kevinferrare/arduino-st4/Hardware/final_back.jpg

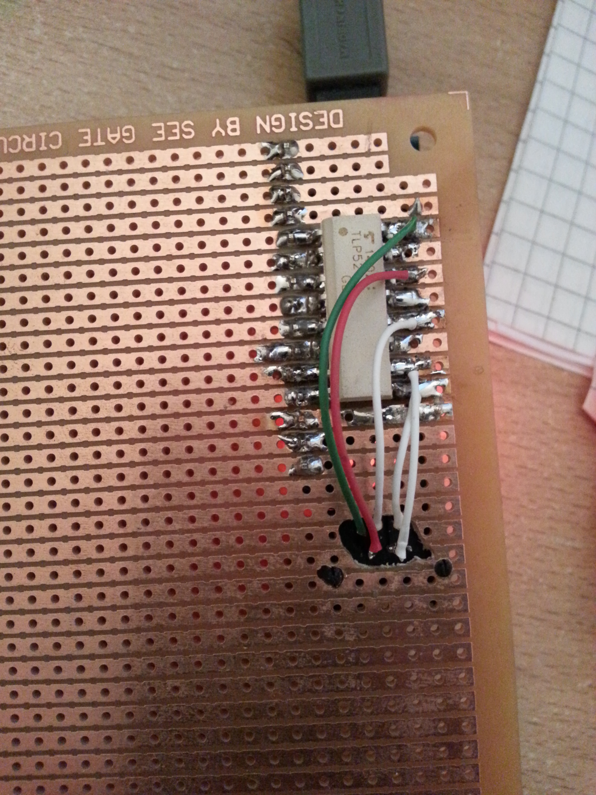
Hardware/final_back.jpg
