kevinferrare/arduino-st4/Hardware/final_case.png

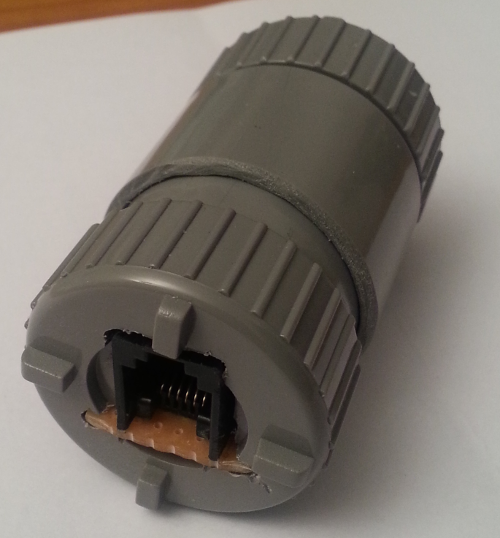
Hardware/final_case.png
