kevinferrare/arduino-st4/Hardware/final_front.jpg

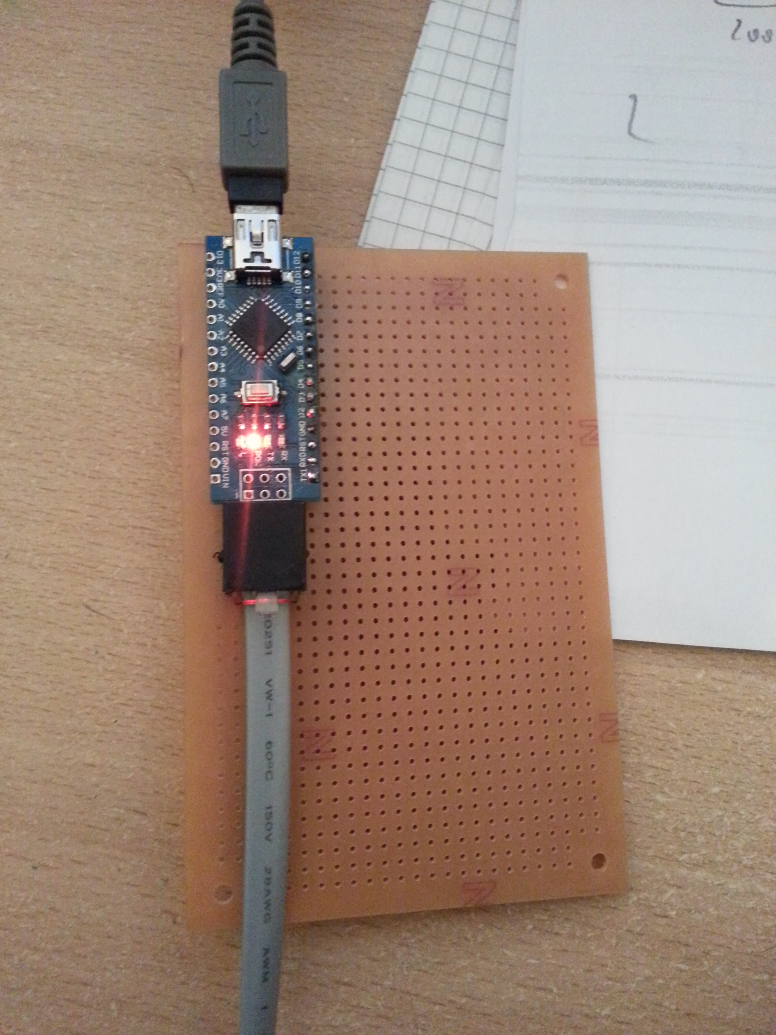
Hardware/final_front.jpg
