kevinferrare/arduino-st4/(threads)

Thread 2 (2016-02-14):

ST-4 upload issue

gary143616, 2016-02-14:
I have uploaded the software and received a"finished uploading" message, the red LED is on, the green LED stopped flashing  but the hardware does not seem to respond to commands, COMMAND+# does not turn the LED on or off, the only change is that a yellow LED gives one fast flick when the command is executed.
I also have a window with the following message:
void setup() {
  // put your setup code here, to run once:

}

void loop() {
  // put your main code here, to run repeatedly:
This is my first contact with Arduino and uploading code so I have no idea what to do next.
I would very much appreciate some assistance.
Thanks,
Gary

kevinferrare, 2016-04-11:
Hello Gary,

It seems that you are uploading an empty arduino program instead of the sketch I link in the installation steps.

If this is the first time you use an arduino, I recommend that you try to upload the examples built-in with the arduino IDE software.
There are a lot of resources on the internet on how to do so.
You could start with the arduino forums.

Closed 2016-07-25.

Thread 3 (2016-07-20):

INDI driver

tliff, 2016-07-20:
I've got a basic INDI driver working for the arduino adapter https://github.com/tliff/indi_ardust4.

Just autoguiding, no GOTO but it's a start.

kevinferrare, 2016-07-25:
Hello @tliff,

Thank you for implementing this!
I will link your code from the main page.
Implementing GOTO was a bit tricky with ASCOM since I had to use threads in order to emulate asynchronous slewing.

Regards,
Kevin

Thread 4 (2017-08-09):

Only 1 program can be connected to the Arduino trough the ASCOM driver

grozmaistor, 2017-08-09:
Only one program for instance Skycharts or PHD can be connected at a time, while the idea of ASCOM is to have the possibility to connect many via the ASCOM driver.

As I see it, the driver should be rewritten in a way that it determines the Arduino device on which port is running and the user is forbidden or hidden the selection for COM port.
Also when you connect a program(PHD) via the ascom driver to the device and disconnect it, the next time you try to connect to the device on the com port it fails, unless you restart the program(PHD).

kevinferrare, 2017-08-12:
Hello,

I am not sure I understand all your points.
Regarding the possibility to have multiple clients for a driver, I am not sure ASCOM supports it.
There is a software that acts as a hub between clients and driver here if it can help: http://www.optecinc.com/astronomy/downloads/ascom_server.htm

Regarding the issue with PHD, I did some tests, and PHD never tells the driver to disconnect, so I made a fix and included it in the next version that is to be released once I properly test it in the field ...
Here is the exe if you are interrested:
https://drive.google.com/open?id=0B04IJvbw0nqmMUJVX25MQ2NJNFU

kevinferrare, 2017-08-17:
Seems like PHD is never disconnecting the driver when clicking on disconnect:
https://github.com/OpenPHDGuiding/phd2/blob/master/scope_ascom.cpp#L416

kevinferrare, 2017-08-17:
@grozmaistor
You can use the Hub included into ASCOM that allows multiple clients to control a single device simultaneously:
http://www.ascom-standards.org/FAQs/POTH.htm

Highland-Logan, 2025-03-09:
The ASCOM Hub, will not allow full useable, as slewing appears to not function. However you can use the [Optec ASCOM Server](https://ftp.optecinc.com/downloads/legacy/optecascomserver/). I am able to slew to targets using NINA, while connected to Stellarium to centre scope and PHD2 as guiding program.

Thread 6 (2017-12-26):

Arduino st-4 driver not recognised by ASCOM

borsaci06, 2017-12-26:
Thank you for your wonderful work. I made the hardware with Arduino Nano and tried to use it on my EQ5 mount. I already have latest ASCOM platform installed and using Cartes du Ciel. I downloaded and installed your Arduino st-4 driver and tried it on CartesDuCiel. however when trying to connect to telescope, I select the ArduinoST-4 (I see it on the list of available HW) it says that the driver is incompatible and does not let me to enter Properties window. Actually it says that the DLL file is not found in CommonFiles/ASCOM/Telescope directory, but when I check the file it looks for is there.
Any help will be appreciated... I really want this to work...

DominiqueMACHU, 2018-03-10:
Hello,
I realized this project with an Arduino R3 (ch340) and no problem with "Cartes du Ciel " and Stellarium. In the presentation of my project,  I explain the configuration of these applications:

https://github.com/DominiqueMACHU/Interface-Arduino-ST4-for-NEQ5/tree/Hardware

Greetings

Dominique

Thread 7 (2018-03-09):

My version of "Arduino ST4"  for my NEQ5

DominiqueMACHU, 2018-03-09:
Hello Kevin,
A big thank you for your project, I realized this winter my version based on an ARDUINO UNO R3 (ch340) for my mount NEQ5.
I just finished the tests everything is OK.
I come to publish the realization of this project on GitHut :

https://github.com/DominiqueMACHU/Interface-Arduino-ST4-for-NEQ5

I look forward to your new version.

friendships

Dominique (Lyon-France)

kevinferrare, 2018-03-13:
Hi Dominique,

I would be interested in seing what you did, but the repository your link points to only has a readme.md file.

Did you commit your files?

Kind regards,
Kevin

DominiqueMACHU, 2018-03-13:
Hi Kevin,

The file is in the branch "hardware", i copy them in master branch.
Excuse me it's my first utilisation of GITHUB!

Kind regards,

Dominique

kevinferrare, 2018-03-13:
Oh!

I see you made a nice PDF manual explaining how to build the hardware and how to use it in various softwares.
However I see no code although I see that the configuration window is different from your screenshots.
Did you change the code?

DominiqueMACHU, 2018-03-13:
No,  I did not change the code, it's version 1 of your original code.

In my first version I had cabled the Rj12 as the standard ST4 :
"ST-4 style guide ports (sometimes referred to as home ports or CCD ports) look
like the diagram shown to the right. The pins are connected as:
Pin 1: Not usually connected
Pin 2: Common (ground)
Pin 3: RA +
Pin 4: Dec +
Pin 5: Dec-
Pin 6: RA
"
-->  and all orders were reversed!
I had modified your code by inverting the controls and the telescope go well on the targets.
Finally I rewired the case "Dual Axis" and install your original code V1.
The telescope goes well on its targets in GOTO mode, the only problem encountered in your version is the passage of the meridian where the DEC commands are reversed!
I am waiting for your official version for this modification, in your ASCOM driver? I think ?.

Thank you for your project this interface ST4 is a + to find the objects of the sky since a star of reference.

Sincerely

Thread 8 (2018-08-14):

Autoguider

hmovahedim, 2018-08-14:
hello sir.
how can use it for my autoguider ?
and how can i send amount of changes to arduino ?

kevinferrare, 2018-08-31:
Arduino only supports on / off commands for both axis.
Timing is handled in the ASCOM driver.

hmovahedim, 2018-08-31:
Thanks.
It's very useful.

Thread 11 (2020-12-16):

Question regarding pooling rate

CyberianIce, 2020-12-16:
If PHD2 sends RA+# command over ST4 interface, for how long this "button" should remain pressed? What happen if you hit RA+ button on your remote? How many steps single press of buttons make?

CyberianIce, 2020-12-24:
More important is how your ArduinoST4 ASCOM driver handle PulseGuide duration opcodes?

kevinferrare, 2021-01-26:
Hello @CyberianIce !

It remains pressed until RA0, RA- or RESET is issued, so the telescope will move until told to stop.
If you hit RA+ on the remote, it probably won't affect the move. The number of steps depends on your specific mount and the duration of the press.

PulseGuide takes in input a direction and a duration, the driver then sends a command to the arduino to start the move in that specific direction, waits for the specified duration and then stops.

Hope this answers your questions.

Thread 12 (2021-08-16):

Connection timed out

Ferwol, 2021-08-16:
Hi!
I am having a hard time making st4 work. When I try to connect I get a time out error
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
Already tried changing COM baudrate to 57600 and nothing happens.
What am I doing wrong?
Thanks!

kevinferrare, 2021-08-16:
Are you able to send commands through the arduino IDE as suggested in the readme?

Ferwol, 2021-08-16:
Yes, and I see "OK#" after sending commands

Ferwol, 2021-08-16:
Should I try an older version of Ascom platform? I am stuck with this error 😵😵

Ferwol, 2021-08-16:
I am using a ch340 Arduino Nano. On a couple of days will be trying with an original one.

Ferwol, 2021-08-18:
Well, It seems that one problem was I was using a copy if Nano and not the original. Now I can connect Cartes du ciel to st4. Phd2 is being a bit more tricky, but that is a different issue.
Thanks for the attention!

Closed 2021-08-18.

Thread 13 (2021-08-19):

Can't open properties on PHD2

Ferwol, 2021-08-19:
Hi again.
First of all, thanks for all the work behind this proyect.
I am close to connect "arduinost4" to PHD2. In Ascom diagnostics everything seems fine (screenshot 1), Cartes du Ciel connects to st4 and I can set different COM port in properties.
But, in PHD2 I click on properties button and nothing happens. Trying to connect will send an error (screenshot 2) and if I try to set properties via Device Hub the error is different (screenshot 3).
Tried unistalling and installing Ascom, phd2 and driver several times. Checked registry with CCleaner. Also installed 1.1 driver version. Don´t know what else could I do. I am stuck.
Thank you again!!

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

Closed 2021-08-23.

Thread 14 (2022-09-19):

Implementation on a standalone ATmega328 uP

nevilyoung, 2022-09-19:
Hi Kevin or anybody -
Perhaps I am trying to be too clever because I decided to use an ATmega328 chip on its own for space saving reasons. I can get the autoguider code to work if I go through the standard Arduino microcontroller board, but not through the standalone chip, with which I communicate through a FT232 USB to serial adapter. That works fine for communicating with and successfully programming the uP (eg Blink), but I cannot communicate with the autoguider that has been loaded onto the chip. I suspect that the Autoguider driver cannot see the auotoguider through the FT232 driver. I have tried various combinations of COM ports.
Am I doing something silly here? Would there be conflicts between drivers and ports?
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

SteveBz, 2022-09-19:
If it works from the pc via the usb and ft232 with blink on the 328, it'll work with anything.  It's probably something silly, like a line terminator or baud rate or something.

nevilyoung, 2022-09-20:
OK - so it should work. Baud rates double checked. The autoguider code is as written by Kevin and works fine when run on the microcontroller board. I have put the question to the Arduino forum, so if I find a solution, I will post it here. Thanks.

nevilyoung, 2022-09-21:
Another possibility - Arduino IDE can see the ATmega328 chip through the FT232. Perhaps there is something in the Arduino driver that makes that happen. Perhaps whatever the 'something' is in the Arduino driver is not in Kevin's autoguider driver. Of course he was not considering that the autoguider would be used on a standalone ATmega328 - if that makes a difference.
BTW - I registered on the Arduino forum 24 hrs ago but am 'on hold' while I am being vetted. Can't wait to post my question there.

nevilyoung, 2022-10-01:
Finally found an answer at Arduino forum. In case someone else runs into this problem, here is the long story. Jump to the end to see the solution.

NOTE: I eventually found a solution to this problem (see below), but here is the scenario:
My implementation for a telescope autoguider uses a standalone Atmega328. I communicate with it via an FT232 USB-Serial converter board. I can download Kevin's Arduino Autoguider program to the chip.  I can download Blink to the standalone 328 - it works just fine.

I am using an an autoguiding program called PHD2. PHD2 cannot communicate with the Arduino Autoguider because the computer only sees the FT232 board.

If I instead programmed the Arduino Autoguider program into an UNO board, (which means that I am now using the UNO’s onboard USB-Serial converter), the Arduino Autoguider program works just fine. The is no apparent clash between the autoguider and the FT232 drivers.

My question was: Should it be possible to communicate with the autoguider on the standalone Atmega328 via the FT232?
While I was writing up this post on the forum, I was prompted to look at this post “_Standalone ATMEGA328 with CP2102 USB-Serial Converter_”, which had not cropped up in my previous searches.

@iceeyes1992 – had the exact solution.
_“i had the same problem.i had a atmega328p and a cp2102 with dtr pin.i tried different ways.after spend of 3 days i found the solution.
after burn bootloader to raw atmega328p with arduino as isp or usbasp you must choose only arduino pro or pro mini as your board in tools menu and one of the avr isp or arduino as isp or avr isp mkll as programmer.and then upload your sketch.that’s it.”_

NOTE: I had burned a bootloader onto the Atmega328 earlier via the UNO board. And then had uploaded the Arduino Autoguider sketch, probably with _Board: Arduino UNO_ selected – I think. Uploading worked fine, but PHD2 did not see the autoguider. The COM port was 4 and called something like “_Serial Converter_” when I was expecting to see “_ArduinoST4 telescope driver (ASCOM)_”.

So – following the advice from @iceeyes – I reconnected to the standalone ATmega through the FTP232 converter. I simply selected _Board: “Arduino Pro or Pro Mini_”. An extra field opens up – _Processor_, from where I selected the “_Atmega328P (5V, 16Mhz)_”. I then uploaded the AutoguiderST4 program again.

The PHD2 guiding program then saw the “_ArduinoST4 telescope driver (ASCOM)_” in the _Mount_ selection list in PHD2.  Success! Guiding is working fine.

(Note: PHD2 will not connect to the autoguider after the Arduino IDE has been connected to the 328. Messages received were COM4 denied or other times response too slow. I had to unplug the autoguider, then plug it in again. )

Bottom line – for standalone Atmega through USB-Serial converter, **_Select Arduino pro or pro mini as your board_**.
PS: I might be mistaken about some of the sequences, but became very confused while sorting out the problem over several days. Hope this is useful.

Thank you Kevin!
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

Thread 16 (2024-07-16):

Adding LED indicators

strumf666, 2024-07-16:
Hi,

First, a big thanks for creating this interface for owners of old mounts. I built it for my eq5, the only thing I am missing are output led indicators.
Can I simply add 5V LEDs between respective optocupler outputs and RJ12 port?

strumf666, 2025-04-07:
Doesn't work as proposed above, but it does work if I wire the led between arduino output and optocoupler input.

Closed 2025-04-07.

Thread 17 (2025-03-19):

Connection timeout with EQMOD

elandrew908, 2025-03-19:
Hi,

I have built a circuit as per Kevin's diagram (thank you Kevin!) with the intention of running an EQ5 mount but I am having an issue connecting to EQMOD. I get an error:  CONNECT ERROR: TIMEOUT

I am using an Arduino Nano 328 (Chinese version). The code loads ok and I can run the test commands OK without an issue. I have installed the ASCOM driver through the installer link provided in the README document.

I check the COM port in Device Manager and use that in EQMOD. However, I am not sure what baud rate to use. I have tried 115200 and 9600 but both don't seem to work. Timeout is set to 2000 and retry is set to 2.

I am assuming that something in my setup is not correct but I can't identify it.

I have also used a different Arduino board, different cable, different computer, different ASCOM platform with no success. I have also tried using a different CH340 driver. I am assuming that something in my settings is not correct but I can't identify it. I'm hoping that someone can provide some guidance on this.

Thank you

SteveBz, 2025-03-19:
I didn't use it with ASCOM, but presumably you set up the BAUD rate in ASCOM.  That should be the same as in the Arduino code.

I've upgrade my hardware since this device, but it worked perfectly for years. I did platesolving and everything.

Good luck.

elandrew908, 2025-03-19:
When you say the BAUD rate in the code, I assume it is this line:

  //57.6k, 8 data bits, no parity, one stop bit.
  Serial.begin(115200, SERIAL_8N1);

I am working with 115200 but does it need to be a specific number?

When using with PHD2, I get a similar error:

_ASCOM driver problem during connection: (ASCOM.Utilities) Timed out waiting for received data_

However, when running through PHD2, I don't know where to set up the baud rate - only COM port and Axis Sideral Rates.
 I get a similar error with Cartes du Ciel:

_The ASCOM driver report an error: Timed out waiting for received data_

Again, I don't see where I can setup the baud rate in this software.

I feel I've missed setting up the baud rate somewhere.

SteveBz, 2025-03-19:
It has to be the same both sides (ASCOM & Arduino), and it has to be one of the standard rates:

   9600 (default for many Arduino sketches)
   14400
   19200
   28800
   38400
   57600
   115200 (common for high-speed communication)

   But it doesn't matter much which.  If you can find out what your calling software or ASCOM is using and then change the Arduino code to that it should work. 

   Here is what ChatGPT says about ASCOM:
   "ASCOM Device Chooser

    Open ASCOM Device Chooser (either from PHD2, Cartes du Ciel, or standalone ASCOM tools).
    Select the correct driver (e.g., ASCOM Arduino ST4, EQMOD, or whatever driver you are using).
    Click Properties or Settings to access configuration options."
    So just make sure they are the same values both sides.

   Yes, you have correctly identified the line: serial.begin(9600) or something.  I'm also fairly confident that the second parameter "SERIAL_8N1" can be deleted and just let it take the default.  Try it.

   Good luck,

   Steve.

    On 19/03/2025 19:53 GMT elandrew908 ***@***.***> wrote:

    When you say the BAUD rate in the code, I assume it is this line:

    //57.6k, 8 data bits, no parity, one stop bit.

    Serial.begin(115200, SERIAL_8N1);

    I am working with 115200 but does it need to be a specific number?

    When using with PHD2, I get a similar error:

    ASCOM driver problem during connection: (ASCOM.Utilities) Timed out waiting for received data

    However, when running through PHD2, I don't know where to set up the baud rate - only COM port and Axis Sideral Rates.

    I get a similar error with Cartes du Ciel:

    The ASCOM driver report an error: Timed out waiting for received data

    Again, I don't see where I can setup the baud rate in this software.

    I feel I've missed setting up the baud rate somewhere.

    —

    Reply to this email directly, view it on GitHub (https://github.com/kevinferrare/arduino-st4/issues/17#issuecomment-2737938487), or unsubscribe (https://github.com/notifications/unsubscribe-auth/AAMR37WPTEZXXK47DKVG4JL2VHDLXAVCNFSM6AAAAABZKZXL6GVHI2DSMVQWIX3LMV43OSLTON2WKQ3PNVWWK3TUHMZDOMZXHEZTQNBYG4).

    You are receiving this because you commented.Message ID: ***@***.***>

    elandrew908 left a comment (kevinferrare/arduino-st4#17) (https://github.com/kevinferrare/arduino-st4/issues/17#issuecomment-2737938487)

    When you say the BAUD rate in the code, I assume it is this line:

    //57.6k, 8 data bits, no parity, one stop bit.

    Serial.begin(115200, SERIAL_8N1);

    I am working with 115200 but does it need to be a specific number?

    When using with PHD2, I get a similar error:

    ASCOM driver problem during connection: (ASCOM.Utilities) Timed out waiting for received data

    However, when running through PHD2, I don't know where to set up the baud rate - only COM port and Axis Sideral Rates.

    I get a similar error with Cartes du Ciel:

    The ASCOM driver report an error: Timed out waiting for received data

    Again, I don't see where I can setup the baud rate in this software.

    I feel I've missed setting up the baud rate somewhere.

    —

    Reply to this email directly, view it on GitHub (https://github.com/kevinferrare/arduino-st4/issues/17#issuecomment-2737938487), or unsubscribe (https://github.com/notifications/unsubscribe-auth/AAMR37WPTEZXXK47DKVG4JL2VHDLXAVCNFSM6AAAAABZKZXL6GVHI2DSMVQWIX3LMV43OSLTON2WKQ3PNVWWK3TUHMZDOMZXHEZTQNBYG4).

    You are receiving this because you commented.Message ID: ***@***.***>

elandrew908, 2025-03-30:
Thanks Steve for this information.

I ended up ditching EQASCOM as I could not get it to work. I reverted back to the original Arduino code 57600 baud rate and it works with PHD and CdC.

A separate issue, I can't get both PHD and CdC to work at the same time. I get an error along the lines of 'access to COM X is denied'. Is the software exclusive? I've tried starting one package first and then the other but it does not make any difference.

Andrew

SteveBz, 2025-03-30:
Yes, each of them will try to lock the serial port, and only one will succeed. I use indi on on a Raspberry Pi, not ascom, but that's the point of them. Ascom, or indi, will lock the serial port and share the info with whomever asks.

Highland-Logan, 2025-04-12:
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

The ASCOM Hub, will not allow full useable, as slewing appears to not function. However you can use the [Optec ASCOM Server](https://ftp.optecinc.com/downloads/legacy/optecascomserver/). I am able to slew to targets using NINA, while connected to Stellarium to centre scope and PHD2 as guiding program.
