kevinferrare/arduino-st4/(commit log)

2015-01-21 Picture of final version with the case
2015-02-23 Added pullup resistors
2018-09-01 Fixed compilation issue with Arduino IDE 1.8
    [ArduinoCode.ino]
